okameinko/typctr/typctr/circuite/touyu_pomp.pdf

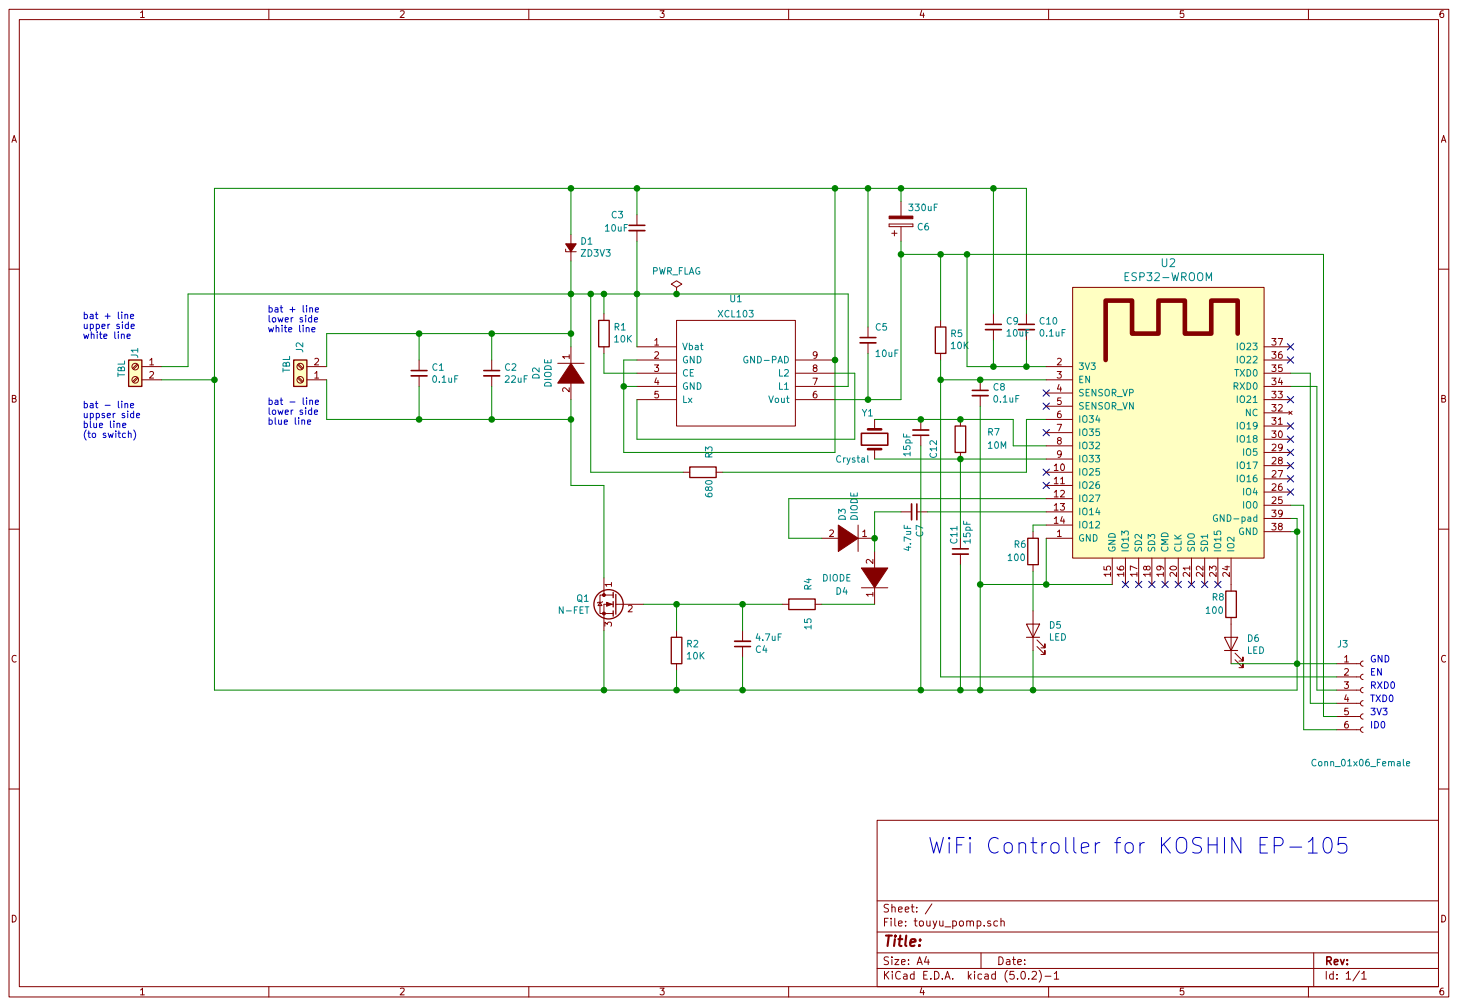
[picture p19: page 1]

bat + line upper side white line

blue line bat - line
uppser side
blue line
